mdiller/weasleyclock/images/example_clock.jpg

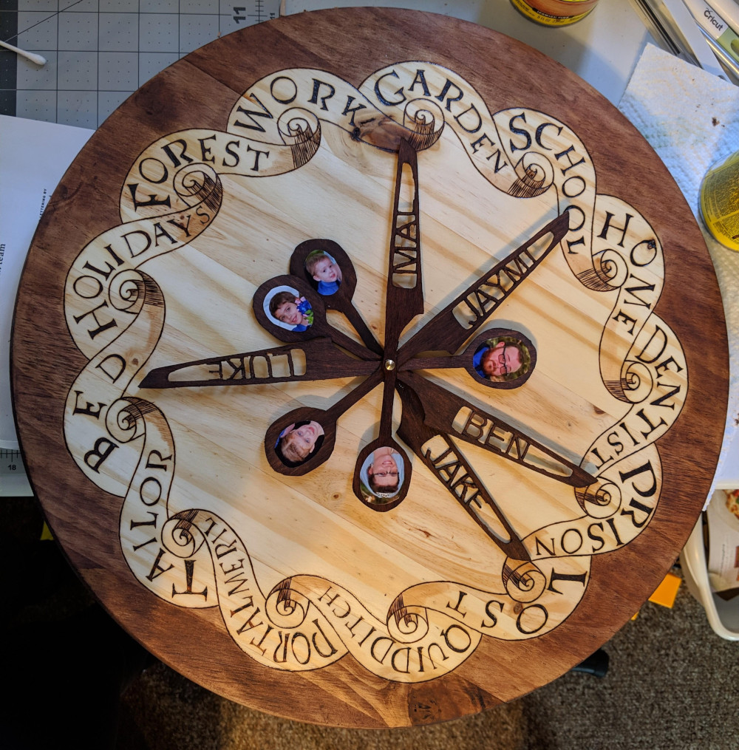
images/example_clock.jpg
