mdiller/weasleyclock/(commit log)

2021-07-08 updated with newest fresh arduino code, changed parents to family, and added clock face drawing
2021-07-10 finished up readme documentation for now, and updated esp code to find shortest path
    [weasleyclock.ino]
